sargantana/OpenTurn/software/BSP/TARGET_OpenTurn/docs/html/board.png

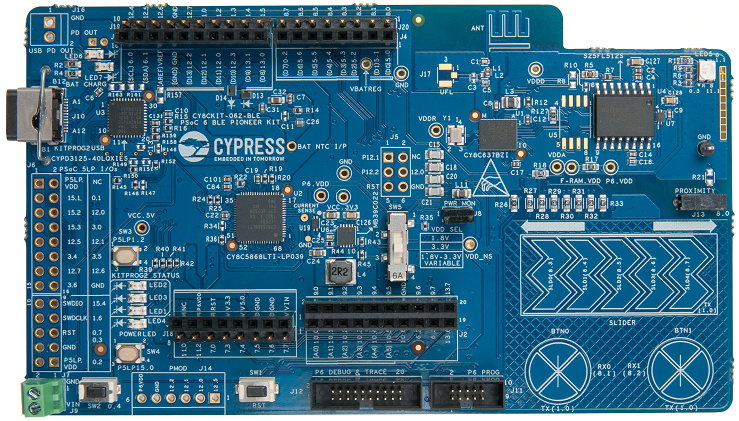
software/BSP/TARGET_OpenTurn/docs/html/board.png
