sargantana/OpenTurn/README.md

# OpenTurn
OpenTurn BLDC Servo Controller
