sargantana/OpenTurn/hardware/3d_models/OpenTurn stand.3mf

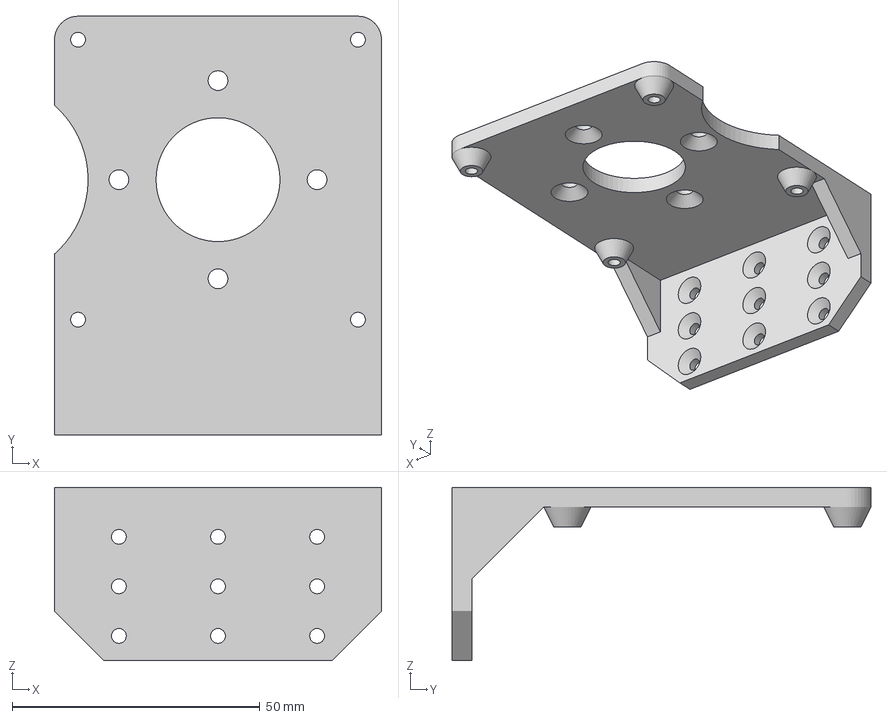
[picture p2: CAD file, 2021-10-14]
hardware/3d_models/OpenTurn stand.3mf
66.0 x 84.5 x 35.0 mm
