sargantana/OpenTurn/(commit log)

2021-05-16 Initial KiCAD Project commit
    [OpenTurn.kicad_pcb, OpenTurn.sch]
2021-05-20 schematic update
    schematic to multiple pages, GPIO assignment optimized for routing
    [Interfaces.sch, MCU.sch, OpenTurn.sch, Power.sch, Power_Stage.sch]
2021-05-21 BSP created
    Modus Toolbox BSP Created
    [qspi_config.cfg]
2021-05-25 Schamtic package assigned
    Package assigned, added two 100nF C's for temp sensors
    [Interfaces.sch, MCU.sch, OpenTurn.sch, Power.sch, Power_Stage.sch]
2021-05-29 pcb draft
    [Interfaces.sch, MCU.sch, OpenTurn.sch, Power.sch, Power_Stage.sch]
2021-06-07 layout redesign started
    [MCU.sch, OpenTurn.kicad_pcb, Power.sch]
2021-06-23 pcb update, kicad 5.99
    PCB Update for review, moved to KiCad 5.99 nightly build
    [Interfaces.kicad_sch, MCU.kicad_sch, OpenTurn - Copy.kicad_pcb, OpenTurn.kicad_pcb, OpenTurn.kicad_sch, Power.kicad_sch, Power_Stage.kicad_sch]
2021-06-25 started fixing DRC errors
    [OpenTurn.kicad_pcb]
2021-06-27 fixing DRC
    [Interfaces.kicad_sch, MCU.kicad_sch, OpenTurn.kicad_pcb, OpenTurn.kicad_sch]
2021-06-27 DRC resolved
    removed GNDA, GNDS from schematic due to no solution was found to get a net-tie in inner layers
    [Interfaces.kicad_sch, MCU.kicad_sch, OpenTurn.kicad_pcb, OpenTurn.kicad_sch, Power.kicad_sch, Power_Stage.kicad_sch]
2021-06-29 DRC passed
    1 error still reported due to placeholder in silkscreen
    [Interfaces.kicad_sch, MCU.kicad_sch, OpenTurn.kicad_pcb, OpenTurn.kicad_sch, Power.kicad_sch]
2021-06-29 added brd pdf
    [OpenTurn.kicad_pcb]
2021-06-29 assigned debug UART to different pins
    debug UART and DRV SPI used same SCB
    [MCU.kicad_sch, OpenTurn.kicad_pcb]
2021-06-30 changed connectors to THT
    changed connectors to THT, removed UART connector
    [Interfaces.kicad_sch, MCU.kicad_sch, OpenTurn.kicad_pcb, OpenTurn.kicad_sch, Power.kicad_sch]
2021-07-02 minor pcb updates
    swapped Encoder Quadrature signals, to provide debug UART
    [Interfaces.kicad_sch, MCU.kicad_sch, OpenTurn.kicad_pcb, OpenTurn.kicad_sch, Power.kicad_sch, Power_Stage.kicad_sch]
2021-07-04 fixed wrong 3d modell path
    [OpenTurn.kicad_pcb]
2021-07-04 fixed 3d model path
    [OpenTurn - Copy.kicad_pcb, OpenTurn.kicad_pcb]
2021-10-14 new project structure
    new project structure to support Modus Toolbox project creation
    [Interfaces.kicad_sch, Interfaces.sch, MCU.kicad_sch, MCU.sch, OpenTurn magnet.3mf, OpenTurn stand.3mf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]
2021-10-14 still fixing this crap
    [OpenTurn-app-manifest-fv2.xml]
2021-10-14 fixed links in example manifest
    [OpenTurn-app-manifest-fv2.xml]
2021-10-15 changes mtb app manifest
    [OpenTurn-app-manifest-fv2.xml]
2021-10-15 test mtb app manifest
    [OpenTurn-app-manifest-fv2.xml]
2021-10-15 updated manifest branches
    [OpenTurn-app-manifest-fv2.xml]
2021-10-15 update BSP
    [qspi_config.cfg]
